xshadowspire/Low-Frequency-Audio-Amplifier/PSF.jpg

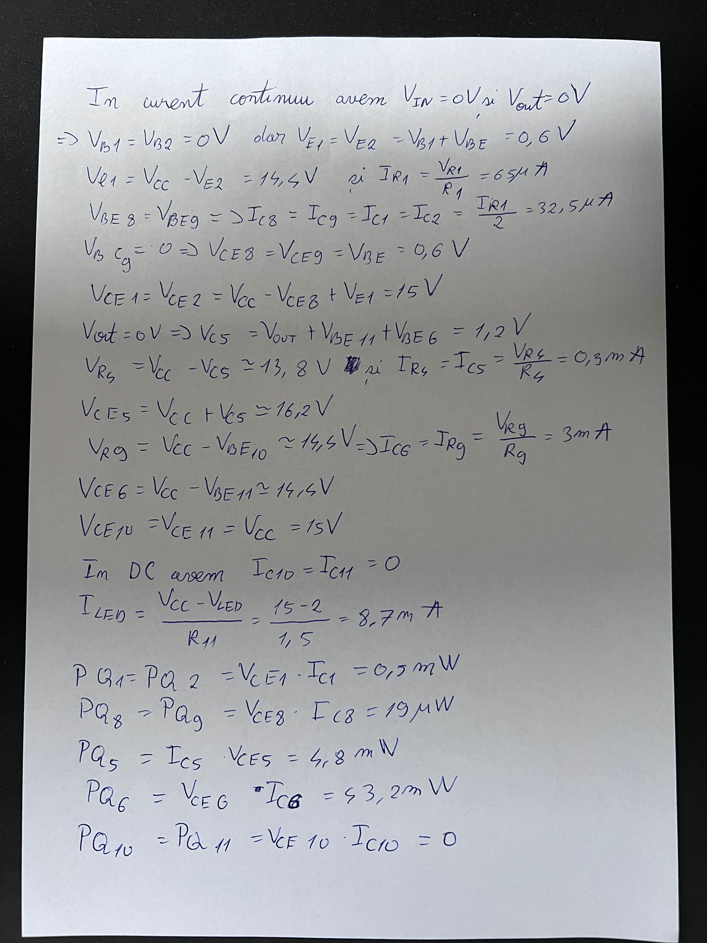
PSF.jpg
