xshadowspire/Low-Frequency-Audio-Amplifier/Schematics/Schema.jpg

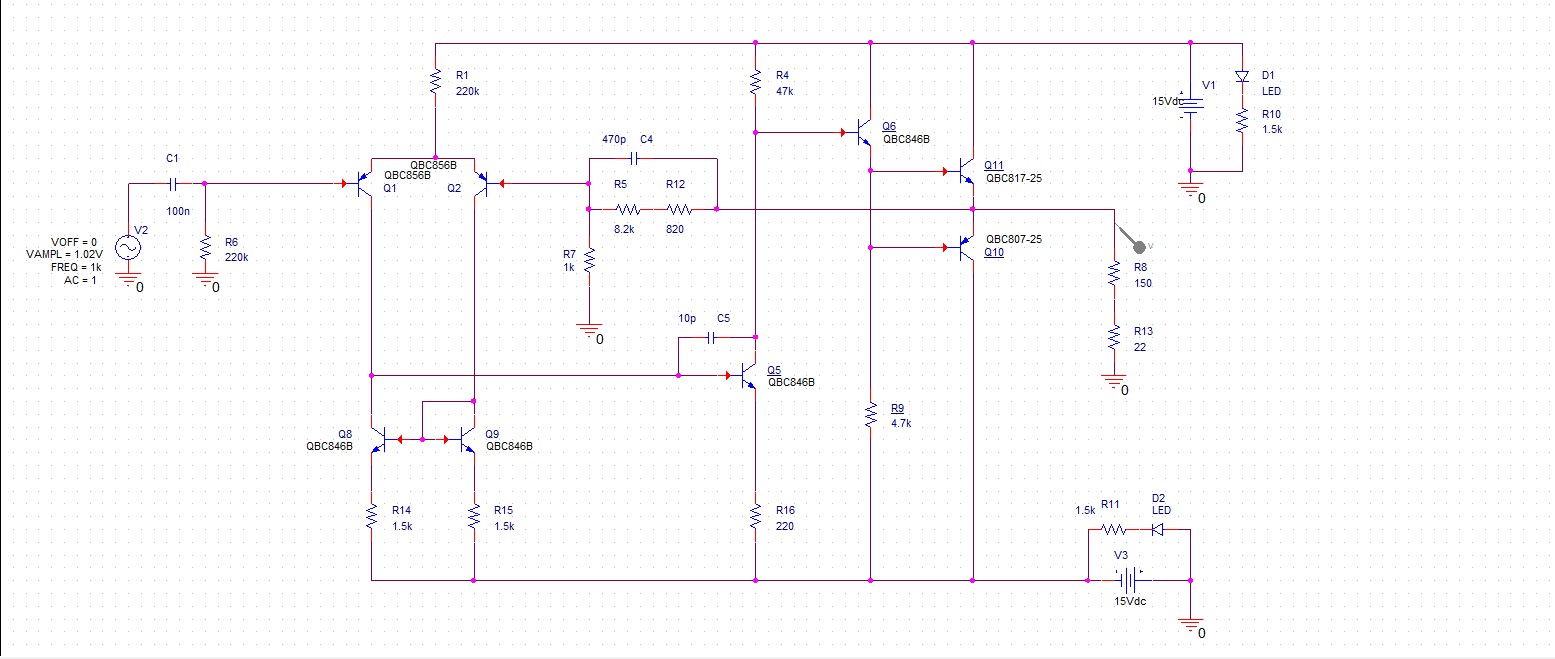
Schematics/Schema.jpg
