xshadowspire/Low-Frequency-Audio-Amplifier/Simulations/Banda frecventei de lucru simulata in temperatura.jpg

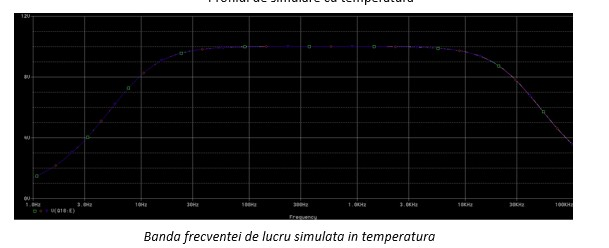
Simulations/Banda frecventei de lucru simulata in temperatura.jpg
