xshadowspire/Low-Frequency-Audio-Amplifier/Simulations/Banda_frecventei_de_lucru.jpg

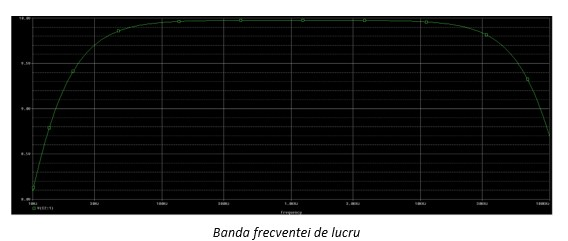
Simulations/Banda_frecventei_de_lucru.jpg
