xshadowspire/Low-Frequency-Audio-Amplifier/Simulations/Forma de unda a semnalului de la iesire simulat in temperatura.jpg

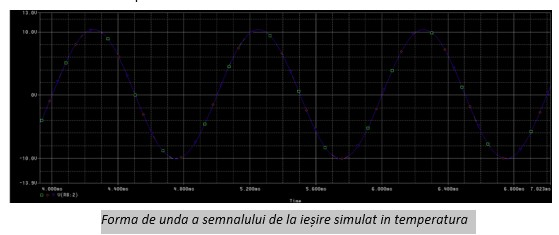
Simulations/Forma de unda a semnalului de la iesire simulat in temperatura.jpg
