xshadowspire/Low-Frequency-Audio-Amplifier/Simulations/Forma de unda a semnalului de la iesire.jpg

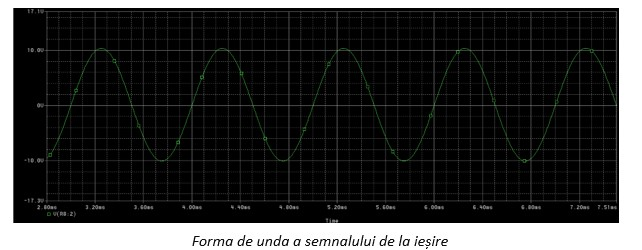
Simulations/Forma de unda a semnalului de la iesire.jpg
