xshadowspire/Low-Frequency-Audio-Amplifier/Simulations/Simularea rezistentei de iesire.jpg

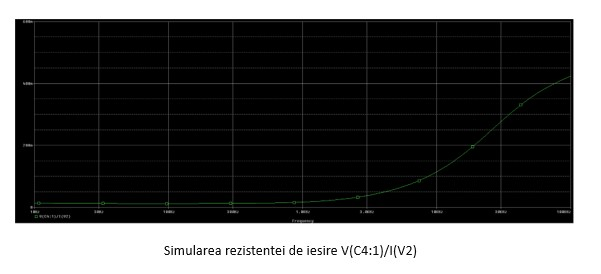
Simulations/Simularea rezistentei de iesire.jpg
