xshadowspire/Low-Frequency-Audio-Amplifier/Simulations/Simularea rezistentei de intrare.jpg

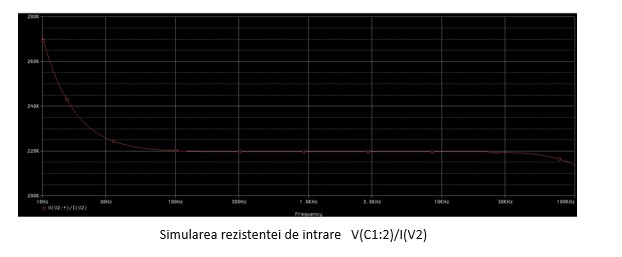
Simulations/Simularea rezistentei de intrare.jpg
