xshadowspire/Low-Frequency-Audio-Amplifier/BOM/BOM(THT).xlsx

Nr. Crt. | Nume | Catalog | Cod distrib | Nume prod | Prod | Clasă | Qty fix | Qty final | Qty min | Descriere | Distribuitor | Pret (fara TVA) referinta/buc. TME România | Pret total pe reper (fara TVA) - propus
1 | 22 ohm | https://www.tme.eu/ro/details/mf0207fte-22r/rezistente-tht/yageo/mf0207fte52-22r/ | MF0207FTE52 | MF0207FTE52 | YAGEO | Rezistor: metal film | 1 | 1 | 1 | Rezistor: metal film; THT; 22Ω; 0,6W; ±1%; 350V | TME | 0.44RON | 0.44RON
2 | 220 ohm | https://www.tme.eu/ro/details/mf0207fte-220r/rezistente-tht/yageo/mf0207fte52-220r/ | MF0207FTE52-220R | MF0207FTE52-220R | YAGEO | Rezistor: metal film | 1 | 1 | 1 | ezistor: metal film; THT; 220Ω; 0,6W; ±1%; 350V; | TME | 0.44RON | 0.44 RON
3 | 820 ohm | https://www.tme.eu/ro/details/mf0207fte-820r/rezistente-tht/yageo/mf0207fte52-820r/ | MF0207FTE52-820R | MF0207FTE52-820R | YAGEO | Rezistor: metal film | 1 | 1 | 1 | Rezistor: metal film; THT; 820Ω; 0,6W; ±1%; 350V; | TME | 0.38 RON | 0.38 RON
4 | 1k ohm | https://www.tme.eu/ro/details/mf0207fte-1k/rezistente-tht/yageo/mf0207fte52-1k/ | MF0207FTE52-1K | MF0207FTE52-1K | YAGEO | Rezistor: metal film | 1 | 1 | 1 | Rezistor: metal film; THT; 1kΩ; 0,6W; ±1%; 350V; | TME | 0.44 RON | 0.44 RON
5 | 1.5k ohm | https://www.tme.eu/ro/details/mf0207fte-1k5/rezistente-tht/yageo/mf0207fte52-1k5/ | MF0207FTE52-1K5 | MF0207FTE52-1K5 | YAGEO | Rezistor: metal film | 4 | 4 | 1 | Rezistor: metal film; THT; 1,5kΩ; 0,6W; ±1%; 350V; | TME | 0.44 RON | 1.76 RON
6 | 8.2k ohm | https://www.tme.eu/ro/details/mf0207fte-8k2/rezistente-tht/yageo/mf0207fte52-8k2/ | MF0207FTE52-8K2 | MF0207FTE52-8K2 | YAGEO | Rezistor: metal film | 1 | 1 | 1 | Rezistor: metal film; THT; 8,2kΩ; 0,6W; ±1%; 350V; | TME | 0.5 RON | 0.5 RON
7 | 4.7k ohm | https://www.tme.eu/ro/details/mf0207fte-4k7/rezistente-tht/yageo/mf0207fte52-4k7/ | MF0207FTE52-4K7 | MF0207FTE52-4K7 | YAGEO | Rezistor: metal film | 1 | 1 | 1 | Rezistor: metal film; THT; 4,7kΩ; 0,6W; ±1%; 350V | TME | 0.44 RON | 0.44 RON
8 | 150 ohm | https://www.tme.eu/ro/details/mf0207fte-150r/rezistente-tht/yageo/mf0207fte52-150r/ | MF0207FTE52-150R | MF0207FTE52-150R | YAGEO | Rezistor: metal film | 1 | 1 | 1 | Rezistor: metal film; THT; 150Ω; 0,6W; ±1%; 350V; | TME | 0.30 RON | 0.30 RON
9 | 47k ohm | https://www.tme.eu/ro/details/mf0207fte-47k/rezistente-tht/yageo/mf0207fte52-47k/ | MF0207FTE52-47K | MF0207FTE52-47K | YAGEO | Rezistor: metal film | 1 | 1 | 1 | Rezistor: metal film; THT; 47kΩ; 0,6W; ±1%; 350V | TME | 0.3 RON | 0.3 RON
10 | 220k ohm | https://www.tme.eu/ro/details/mf0207fte-220k/rezistente-tht/yageo/mf0207fte52-220k/ | MF0207FTE52-220K | MF0207FTE52-220K | YAGEO | Rezistor: metal film | 2 | 2 | 1 | Rezistor: metal film; THT; 220kΩ; 0,6W; ±1%; 350V; Ø0,55x28mm; | TME | 0.066 RON | 0.132 RON
11 | 100 nF | https://www.tme.eu/ro/details/mks2-100n_63/condensatoare-de-film-tht/wima/mks2c031001a00kssd/ | MKS2C031001A00KSSD | MKS2C031001A00KSSD | WIMA | Condensator cu poliester | 1 | 1 | 1 | Condensator cu poliester; 100nF; Ulucru: 63VDC; 40VAC; 5mm; ±10% | TME | 3.00 RON | 3.00 RON
12 | 10 pF | https://www.tme.eu/ro/details/cch-10p_1000v/condensatoare-ceramice/sr-passives/ | CCH-10P/1000V | CCH-10P/1000V | SR Passives | Condensator ceramic | 10 | 10 | 1 |  | TME | 0.43 RON | 4.30 RON
13 | 470 pF | https://www.tme.eu/ro/details/cc-470/condensatoare-ceramice/sr-passives/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 | CC-470 | CC-470 | SR Passives | Condensator ceramic | 100 | 100 | 1 | Condensator: ceramic; 470pF; 50V; ±10% | TME | 0.071 RON | 7.1RON
14 | NPN | https://www.tme.eu/ro/details/bc546b-dio/tranzistori-tht-npn/diotec-semiconductor/bc546b/ | BC546 | BC546 | Diotec Semiconductor | tranzistor | 4 | 4 | 1 | : NPN; bipolar; 65V; 0,1A; 500mW; | TME | 0.50 RON | 2.00 RON
15 | PNP | https://www.tme.eu/ro/details/bc556b-dio/tranzistori-tht-pnp/diotec-semiconductor/bc556b/ | BC556 | BC556 | Diotec Semiconductor | tranzistor | 2 | 2 | 1 | PNP; bipolar; 65V; 0,1A; 500mW | TME | 0.50 RON | 1.00 RON
16 | PNP | https://www.tme.eu/ro/details/bc327-40-dio/tranzistori-tht-pnp/diotec-semiconductor/bc327-40/ | BC327 | BC327 | Diotec Semiconductor | tranzistor | 1 | 1 | 1 | PNP; bipolar; 45V; 0,8A; 625mW | TME | 0.60 RON | 0.60 RON
17 | NPN | https://www.tme.eu/ro/details/bc337-40-dio/tranzistori-tht-npn/diotec-semiconductor/bc337-40/ | BC337 | BC337 | Diotec Semiconductor | tranzistor | 1 | 1 | 1 | NPN; bipolar; 45V; 0,8A; 625mW | TME | 0.60 RON | 0.60 RON
18 | NPN | https://www.tme.eu/ro/details/bd241c/tranzistori-tht-npn/stmicroelectronics/ | BD241 | BD241 | STMicroelectronics | tranzistor | 2 | 2 | 1 | NPN; bipolar; 100V; 3A; 40W | TME | 3.30 RON | 6.60 RON
19 | LED | https://www.tme.eu/en/details/l-7113qbc-d/tht-leds-round/kingbright-electronic/ | L-7113QBDL-D | L-7113QBC-D | KINGBRIGHT ELECTRONIC | LED | 2 | 2 | 1 | LED; blue; 5mm | TME | 1.50 RON | 3.00 RON
