xshadowspire/Low-Frequency-Audio-Amplifier/Schematics/pr1-PSpiceFiles/SCHEMATIC1/Bode/Bode.cir

** Profile: "SCHEMATIC1-Bode"  [ C:\Users\xshad\Desktop\P1_2025_431E_Pandele_Florin_AAF_N17_OrCad\Schematics\pr1-PSpiceFiles\SCHEMATIC1\Bode.sim ] 

** Creating circuit file "Bode.cir" 
** WARNING: THIS AUTOMATICALLY GENERATED FILE MAY BE OVERWRITTEN BY SUBSEQUENT SIMULATIONS

*Libraries: 
* Profile Libraries :
* Local Libraries :
* From [PSPICE NETLIST] section of C:\Users\xshad\AppData\Roaming\SPB_Data\cdssetup\OrCAD_PSpice\17.2.0\PSpice.ini file:
.lib "nomd.lib" 

*Analysis directives: 
.AC DEC 100 1 1M
.OPTIONS ADVCONV
.PROBE64 V(alias(*)) I(alias(*)) W(alias(*)) D(alias(*)) NOISE(alias(*)) 
.INC "..\SCHEMATIC1.net" 


.END
