xshadowspire/Low-Frequency-Audio-Amplifier/(list of files, drawings)

Other design files:
biblioteci spice/1N4148.OLB
biblioteci spice/1n4148.opj
biblioteci spice/BC807-25.OLB
biblioteci spice/bc807-25.opj
biblioteci spice/BC817-25.OLB
biblioteci spice/bc817-25.opj
biblioteci spice/BC846B.OLB
biblioteci spice/BC856B.OLB
biblioteci spice/BZX84C2V7.OLB
biblioteci spice/BZX84C5V1.OLB
biblioteci spice/BZX84C5V6.OLB
biblioteci spice/BZX84C6V2.OLB
biblioteci spice/BZX84C6V8.OLB
biblioteci spice/BZX84C10.OLB
biblioteci spice/diode.olb
biblioteci spice/ebipolar.olb
biblioteci spice/EVALAA.OLB
biblioteci spice/evalp.OLB
biblioteci spice/IRFR120NPBF.OLB
biblioteci spice/MJD31CG.OLB
biblioteci spice/MJD32CG.OLB
biblioteci spice/MMBFJ177LT1G.OLB
biblioteci spice/MMBFJ309LT1G.OLB
biblioteci spice/opto.olb
biblioteci spice/SMLK18WBJxW/SMLK18WBJXW.OLB
biblioteci spice/SMLS14BET/SMLS14BET.OLB
Layout/layout amp2.fzz
Schematics/pr1.dsn
Schematics/pr1.opj
